BertramRay/TsingDetect/(commit log)

2020-10-29 清测康项目源码
    包括模块库函数与arduino代码
2020-10-29 更新项目快速上手文档
2020-10-29 更新项目资料
    上传演示视频，实物图，功能说明书，模块资料
2020-10-29 各部分标定资料
2020-10-29 代码更新
2020-10-29 更新展示资料
    上传检测原理和代码调试总结
2020-11-11 更新实验报告和pre
